Jeff-Birt/MOS8701_HB/Soldering Fixture/IMG_8996.JPG

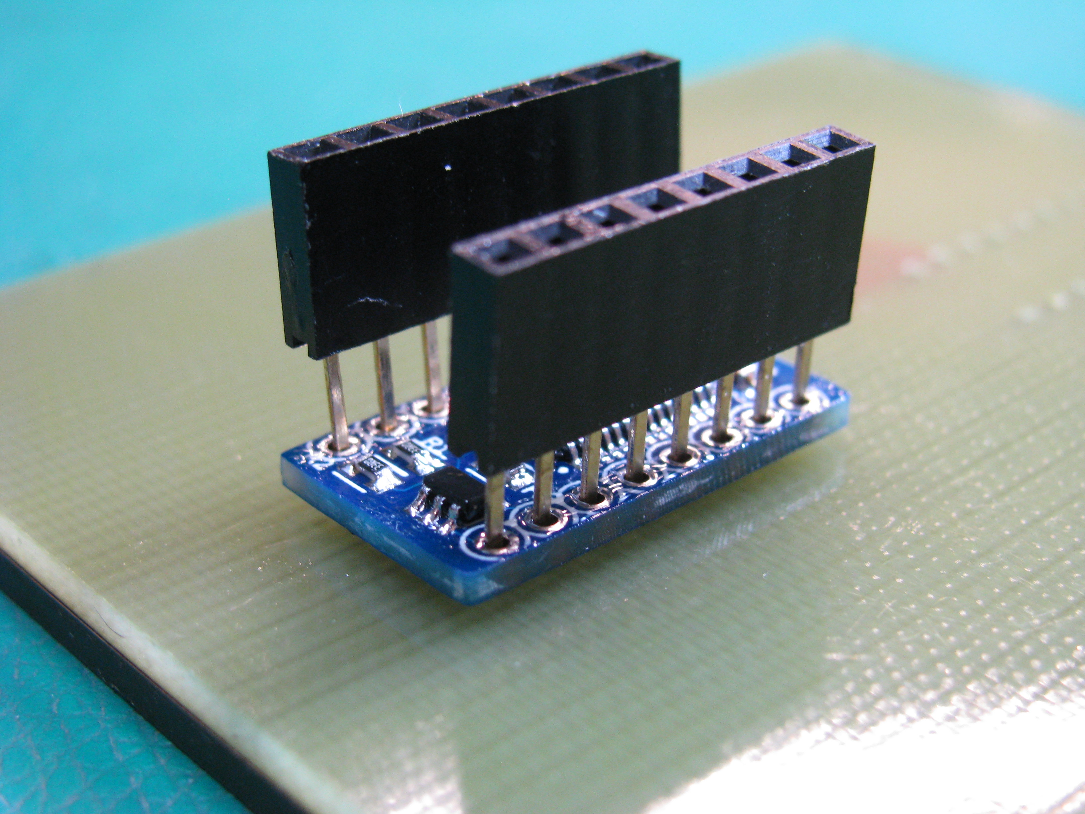
Soldering Fixture/IMG_8996.JPG
