Jeff-Birt/MOS8701_HB/Test Fixture/IMG_8955.JPG

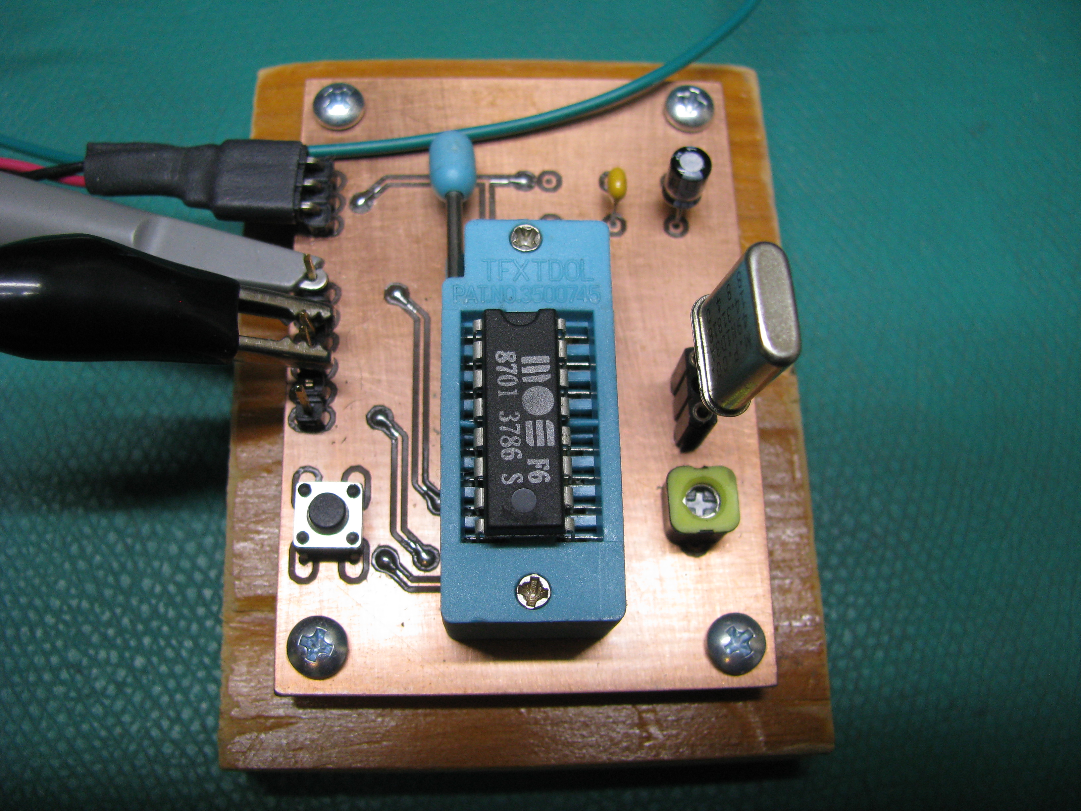
Test Fixture/IMG_8955.JPG
