Jeff-Birt/MOS8701_HB/README.md

# MOS8701_HB
Project files for a MOS8701 replacement. More documentation forthcoming.

For now see: https://youtu.be/e5o8c656j3Q
