Jeff-Birt/MOS8701_HB/Lead Forming Die/Lead Forming Die Set v10.png

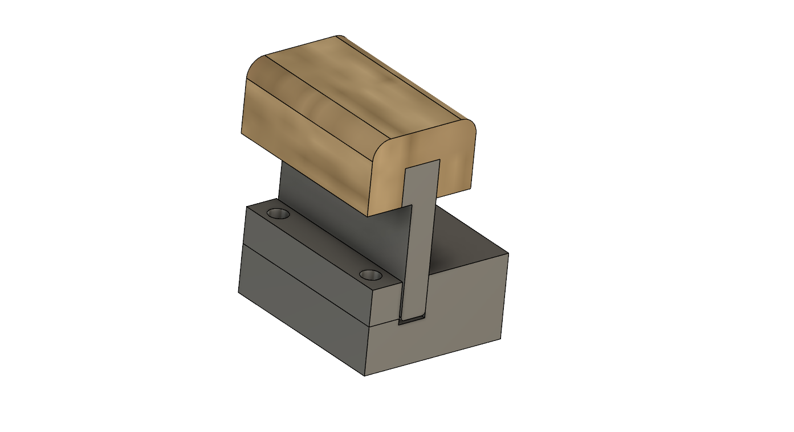
Lead Forming Die/Lead Forming Die Set v10.png
