Jeff-Birt/MOS8701_HB/Lead Forming Die/WP_20200714_13_27_40_Pro.jpg

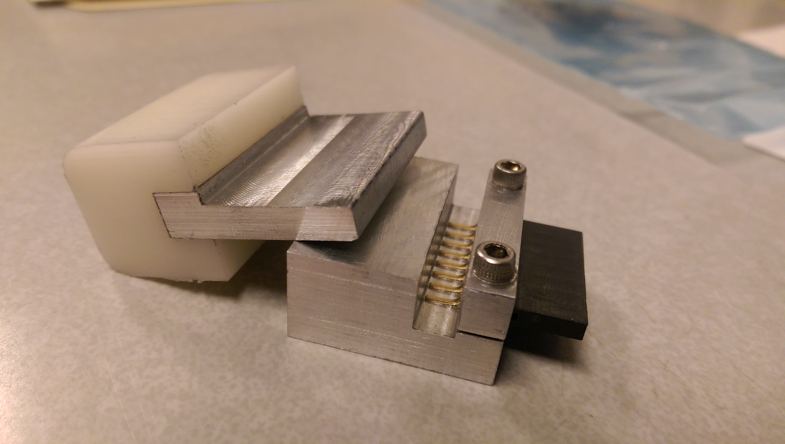
Lead Forming Die/WP_20200714_13_27_40_Pro.jpg
