Jeff-Birt/MOS8701_HB/MOS8701_HB/IMG_8985.JPG

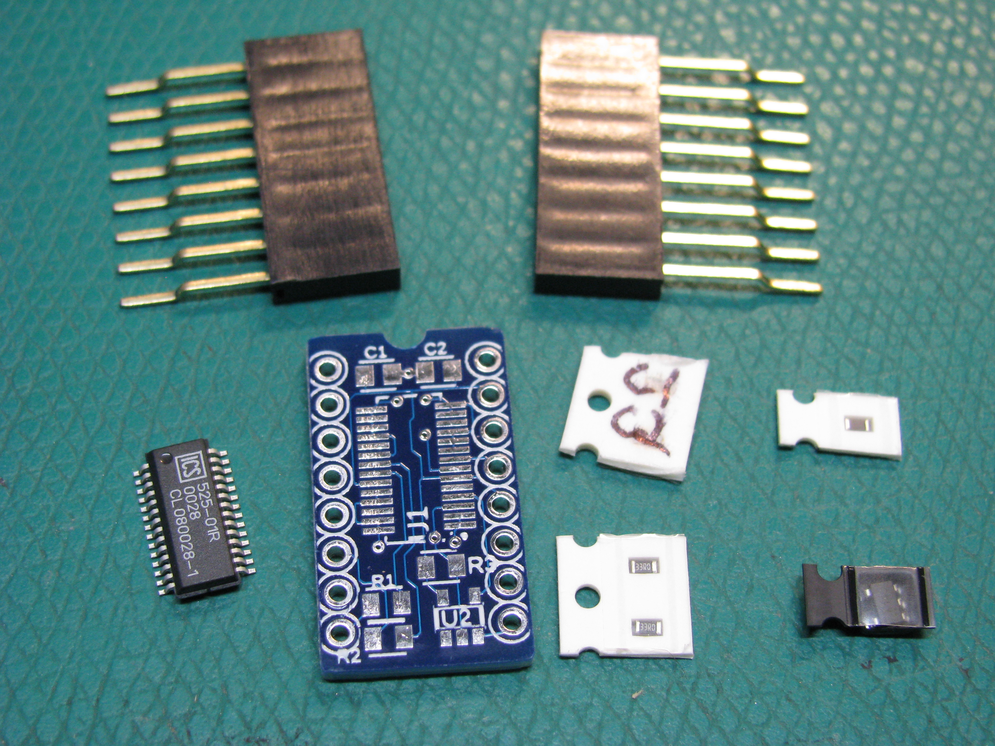
MOS8701_HB/IMG_8985.JPG
