Jeff-Birt/MOS8701_HB/MOS8701_HB/IMG_9003.JPG

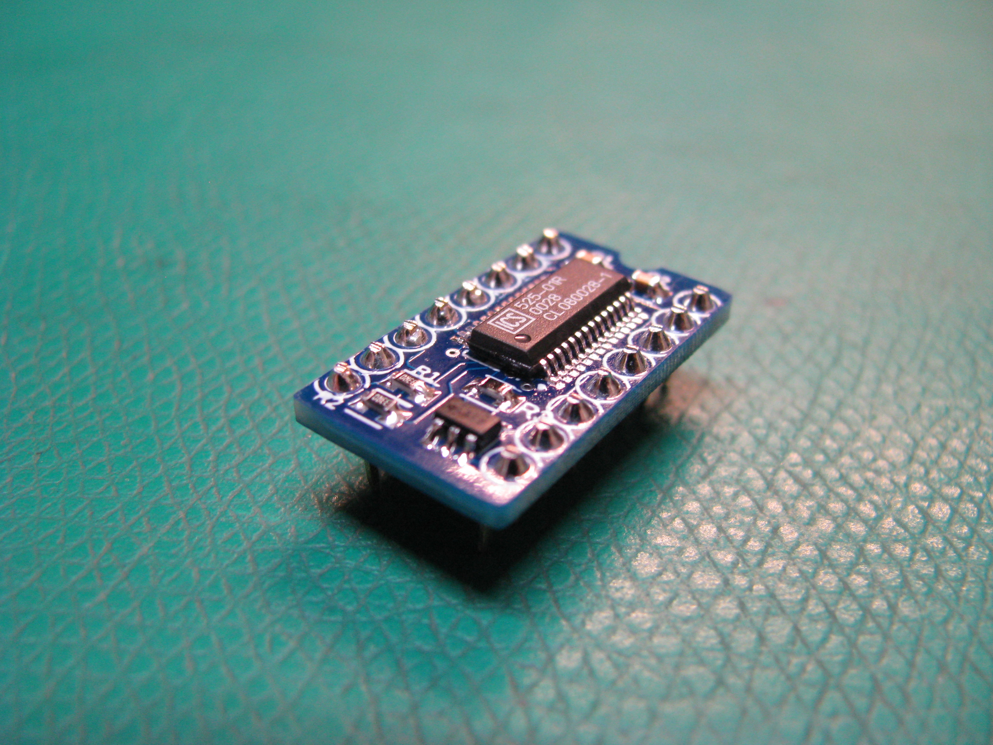
MOS8701_HB/IMG_9003.JPG
