Jeff-Birt/MOS8701_HB/MOS8701_HB/IMG_9005.JPG

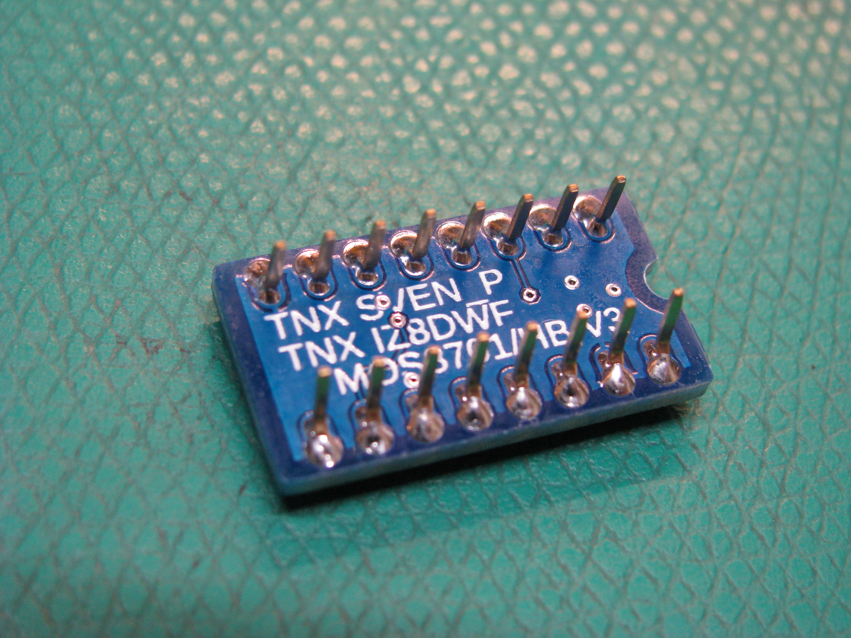
MOS8701_HB/IMG_9005.JPG
