Jeff-Birt/MOS8701_HB/MOS8701_HB/MOS8701_HB Rear v9.png

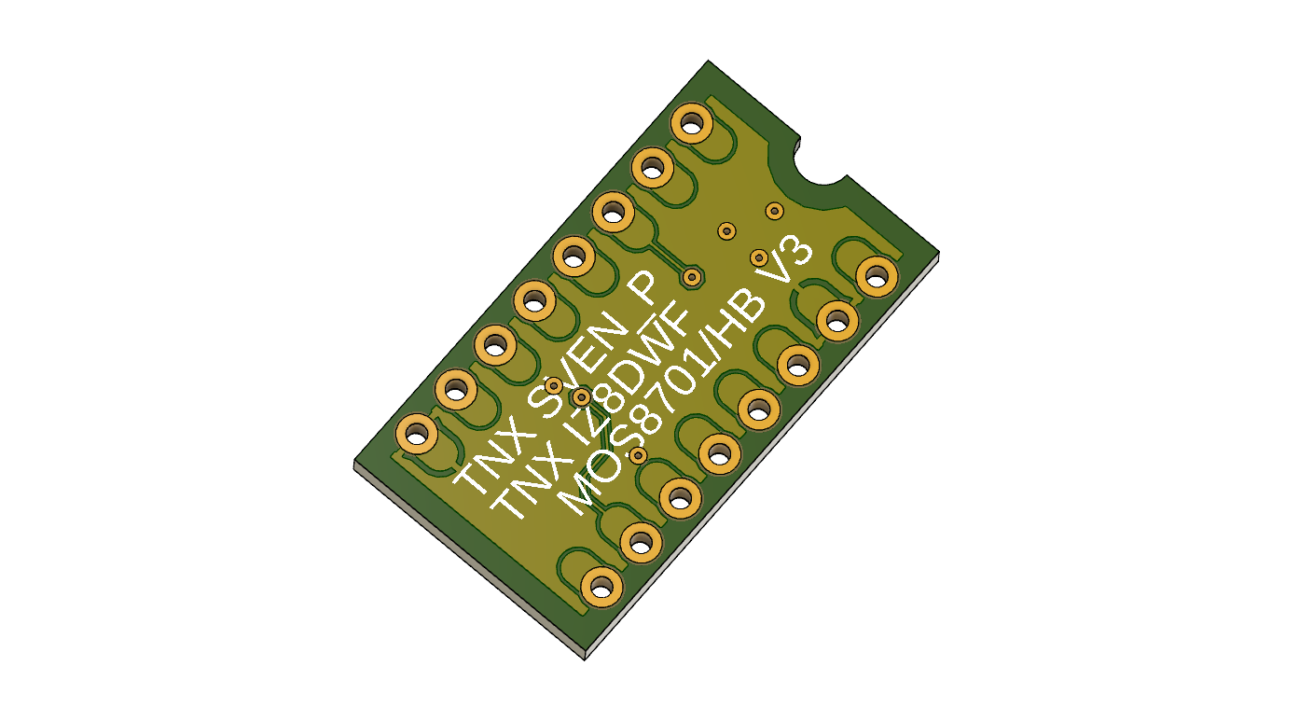
MOS8701_HB/MOS8701_HB Rear v9.png
