Jeff-Birt/MOS8701_HB/MOS8701_HB/MOS8701_HB v8 Component Placement.png

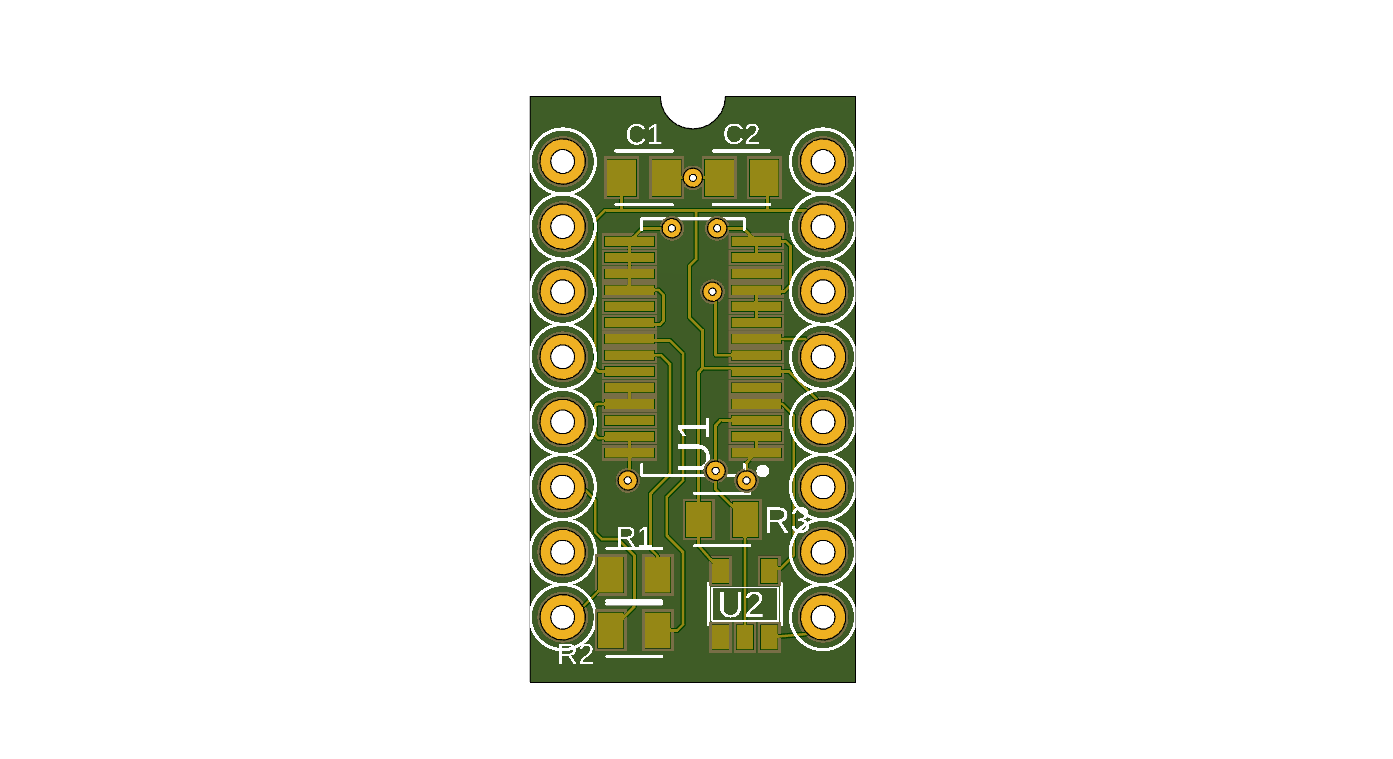
MOS8701_HB/MOS8701_HB v8 Component Placement.png
