Jeff-Birt/MOS8701_HB/Soldering Fixture/Toolpath/Soldering FIxture v1 Sheet1.dxf

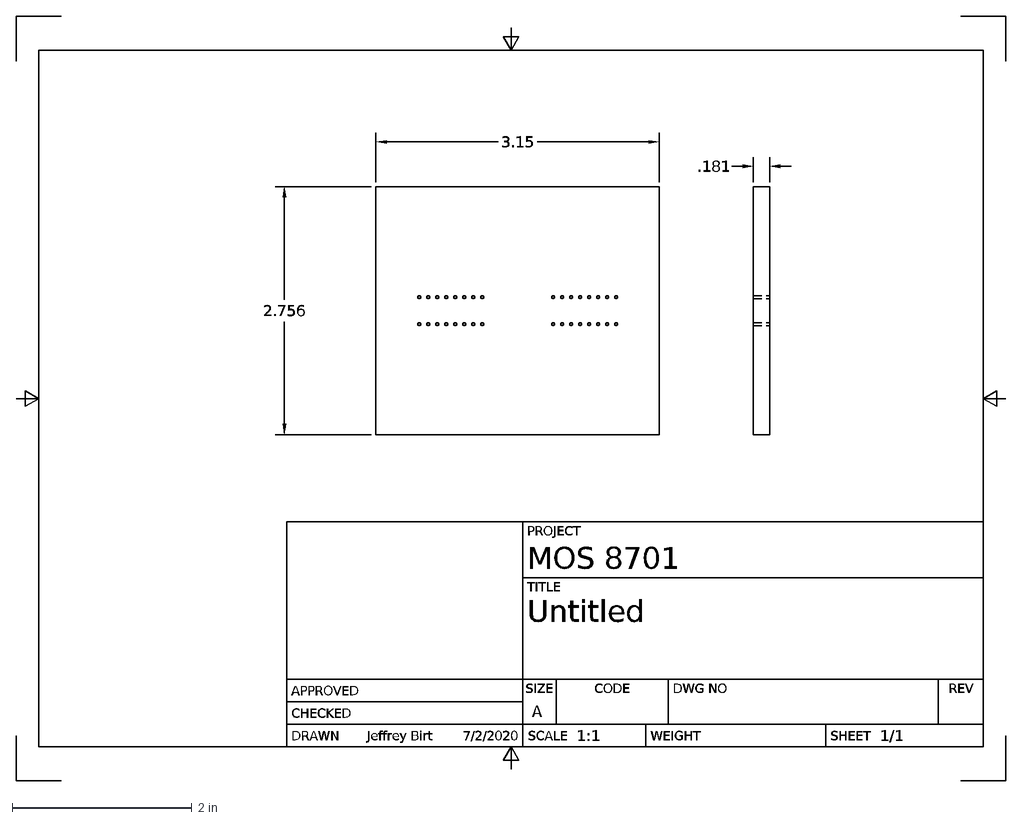
[picture p12: CAD file, 2020-08-23]
Soldering Fixture/Toolpath/Soldering FIxture v1 Sheet1.dxf
1/1
1:1
7/2/2020
Jeffrey Birt
A
MOS 8701
Untitled
PROJECT
TITLE
DRAWN
CHECKED
APPROVED
SCALE
WEIGHT
SHEET
DWG NO
REV
CODE
SIZE
3.15
2.756
.181
