Jeff-Birt/MOS8701_HB/Lead Forming Die/Old 3D Printed Version/Lead Forming Die v6.stl

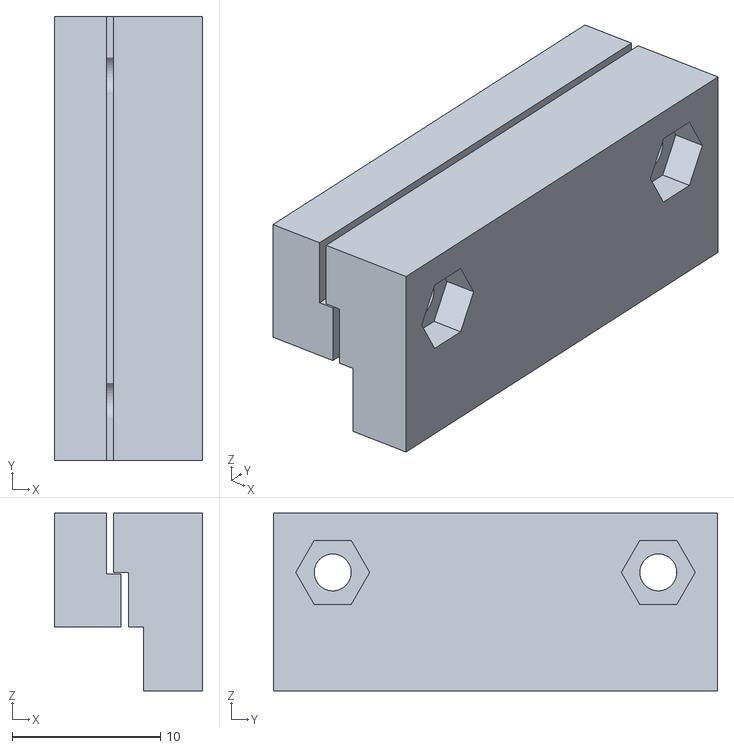
[picture p13: CAD file, 2020-08-23, an earlier design]
Lead Forming Die/Old 3D Printed Version/Lead Forming Die v6.stl
10.0 x 30.0 x 12.0
