Jeff-Birt/MOS8701_HB/(list of files, cad)

Other CAD files:
Lead Forming Die/Lead Forming Die Set v11.f3d
Soldering Fixture/Soldering Fixture v1.f3d
