Jeff-Birt/MOS8701_HB/MOS8701_HB/MOS8701_HB Schematic V8.pdf

2 | 4 U2 R³ | 3 5 GND VCC U2P

A

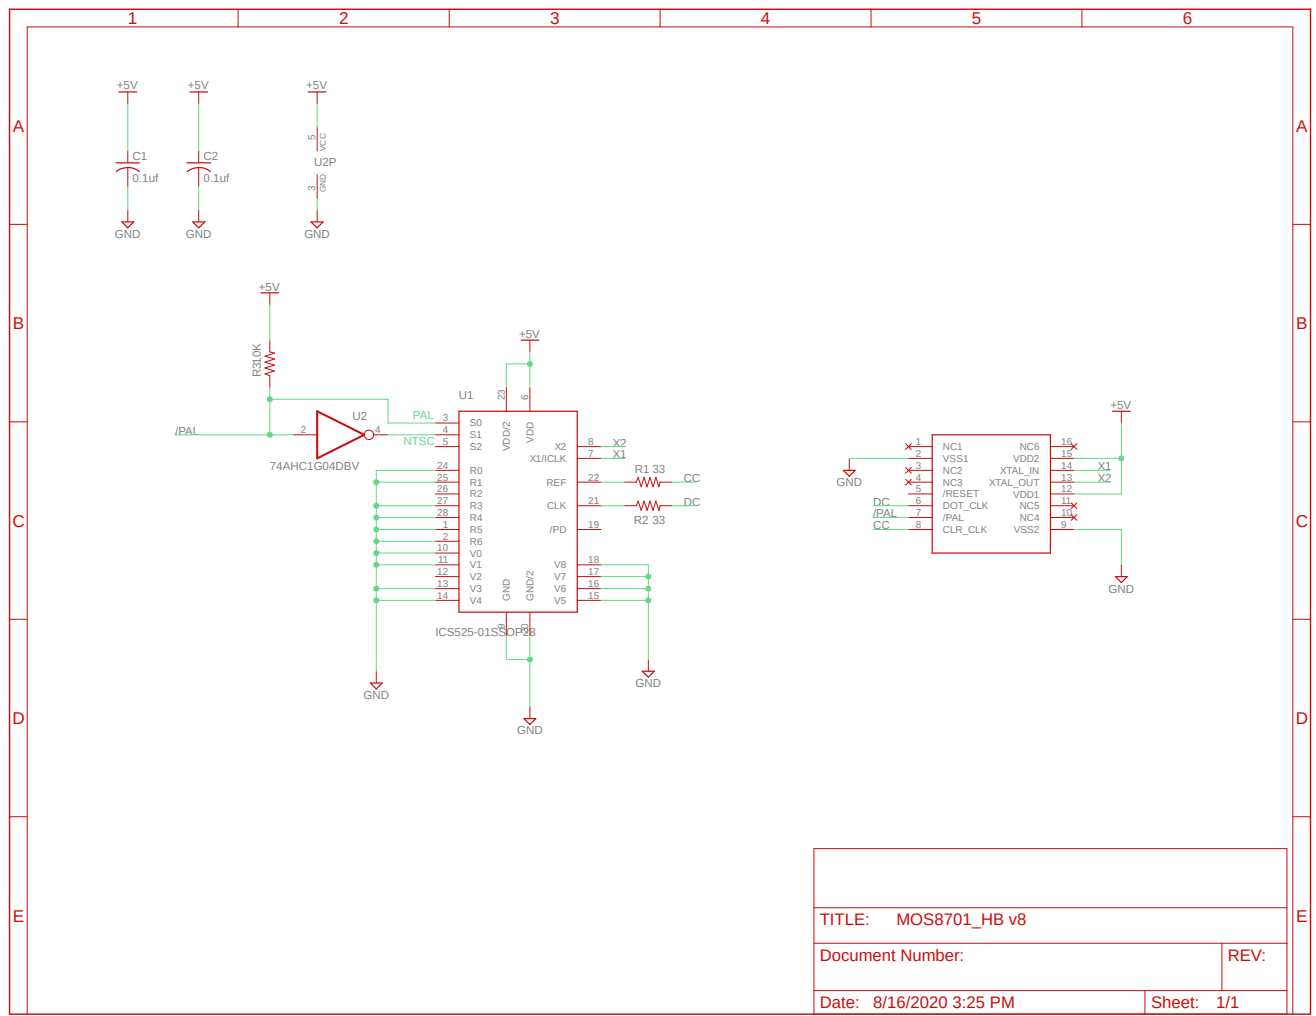
[picture p14: page 1]

9 V0 10 V1 11 V2 12 V3 13 V4 14 R4 28 R3 27 R2 26 R1 25 R0 24 VDD/2 23 GND/2 20 REF 22 CLK 21
PAL

Document Number: | REV:

Date: 8/16/2020 3:25 PM | Sheet: 1/1
