Jeff-Birt/MOS8701_HB/Soldering Fixture/Soldering FIxture v2.pdf

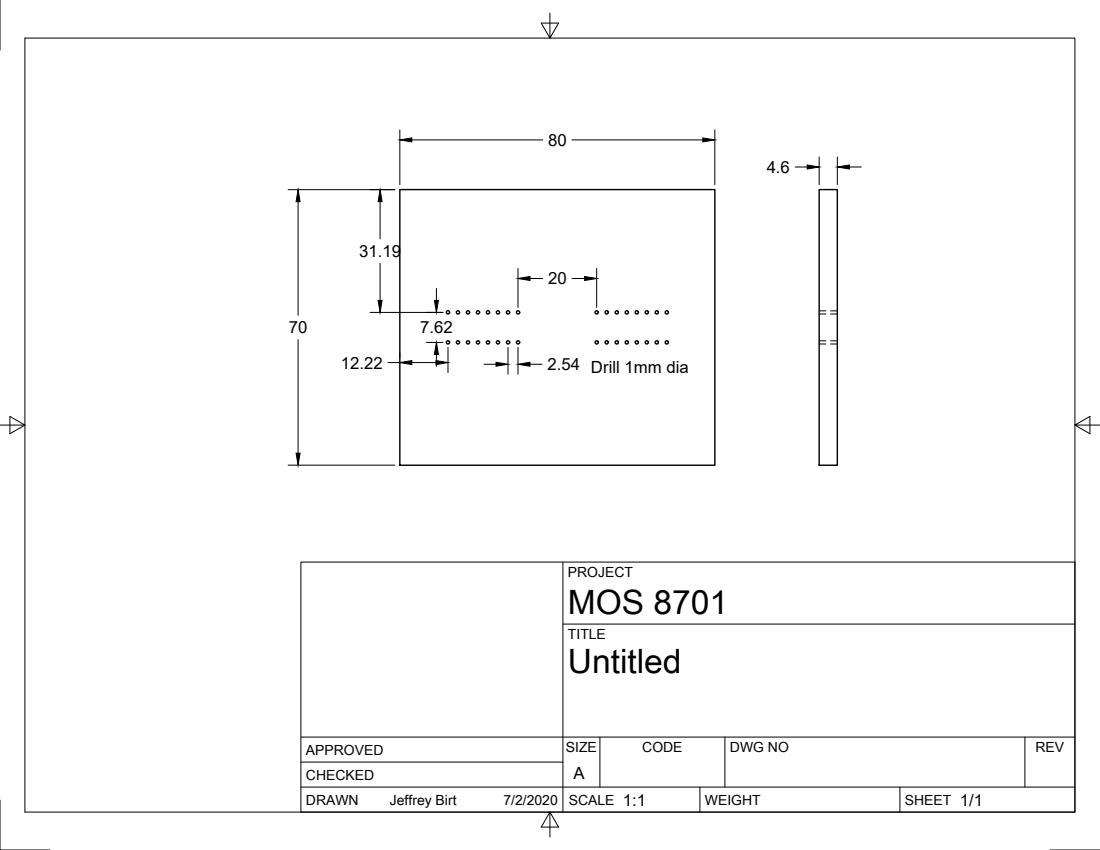
[picture p15: page 1]
SIZE; CODE; DWG NO; REV; Jeffrey Birt; MOS 8701; Drill 1mm dia
