Jeff-Birt/MOS8701_HB/Test Fixture/MOS8701_HB Test Fixture Schematic.pdf

# GND ⁺⁵V

A

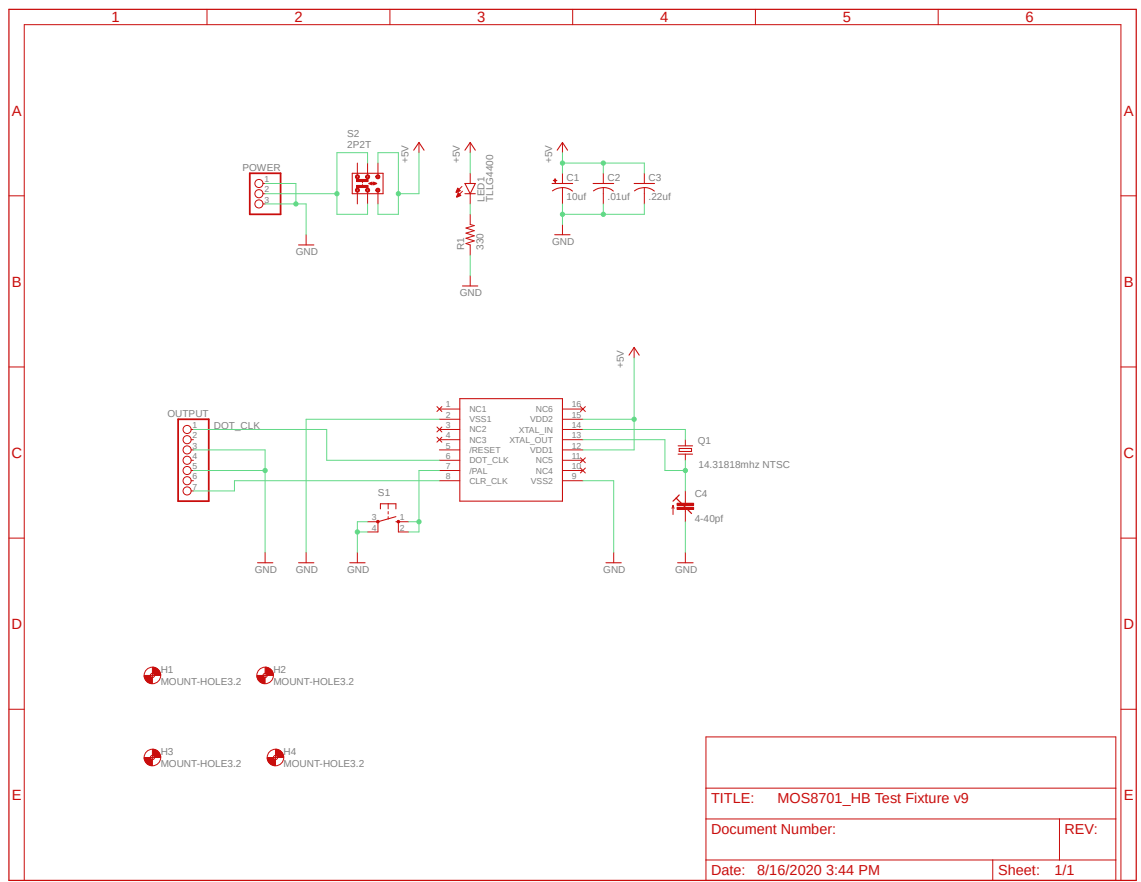
[picture p16: page 1]
14.31818mhz NTSC; GND; GND GND; MOUNT-HOLE3.2; TLLG⁴⁴⁰⁰ 330 +5V; VSS1 2; /RESET 5; DOT_CLK 6; CLR_CLK 8; /PAL 7; 11 VDD2; 15 VDD1; 12 XTAL_IN; 14 XTAL_OUT; 13 VSS2; 7 OUTPUT; 3 POWER; LED¹ R¹; DOT_CLK; TITLE:; MOS8701_HB Test Fixture v9

Document Number: | REV:

Date: 8/16/2020 3:44 PM | Sheet: 1/1
