Jeff-Birt/MOS8701_HB/Lead Forming Die/Lead Forming Die Block v1.pdf

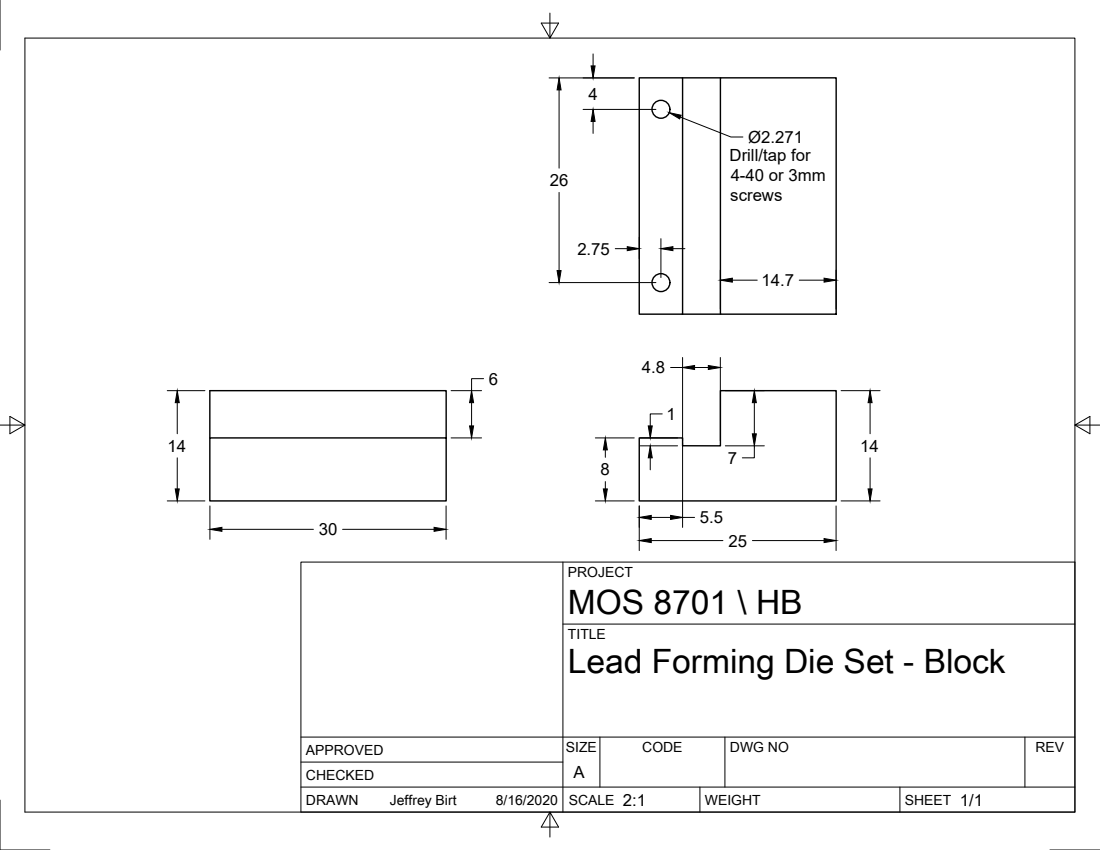
[picture p17: page 1]
SIZE; CODE; DWG NO; REV; Jeffrey Birt; Drill/tap for 4-40 or 3mm

PROJECT
MOS 8701 \ HB
Lead Forming Die Set - Block
