Jeff-Birt/MOS8701_HB/Lead Forming Die/Lead Forming Die Clamp v3.pdf

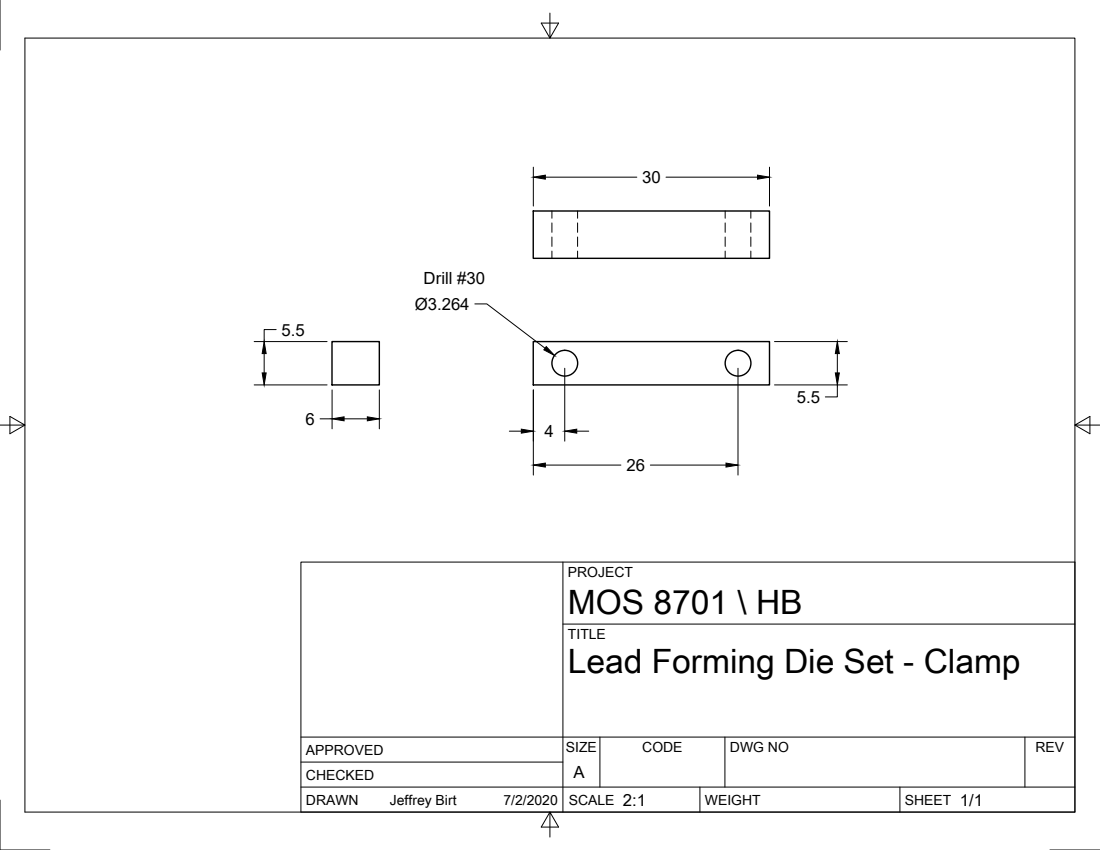
[picture p18: page 1]
SIZE; CODE; DWG NO; REV; Jeffrey Birt; Drill #30

PROJECT
MOS 8701 \ HB
Lead Forming Die Set - Clamp
