Jeff-Birt/MOS8701_HB/Lead Forming Die/Lead Forming Die Punch v5.pdf

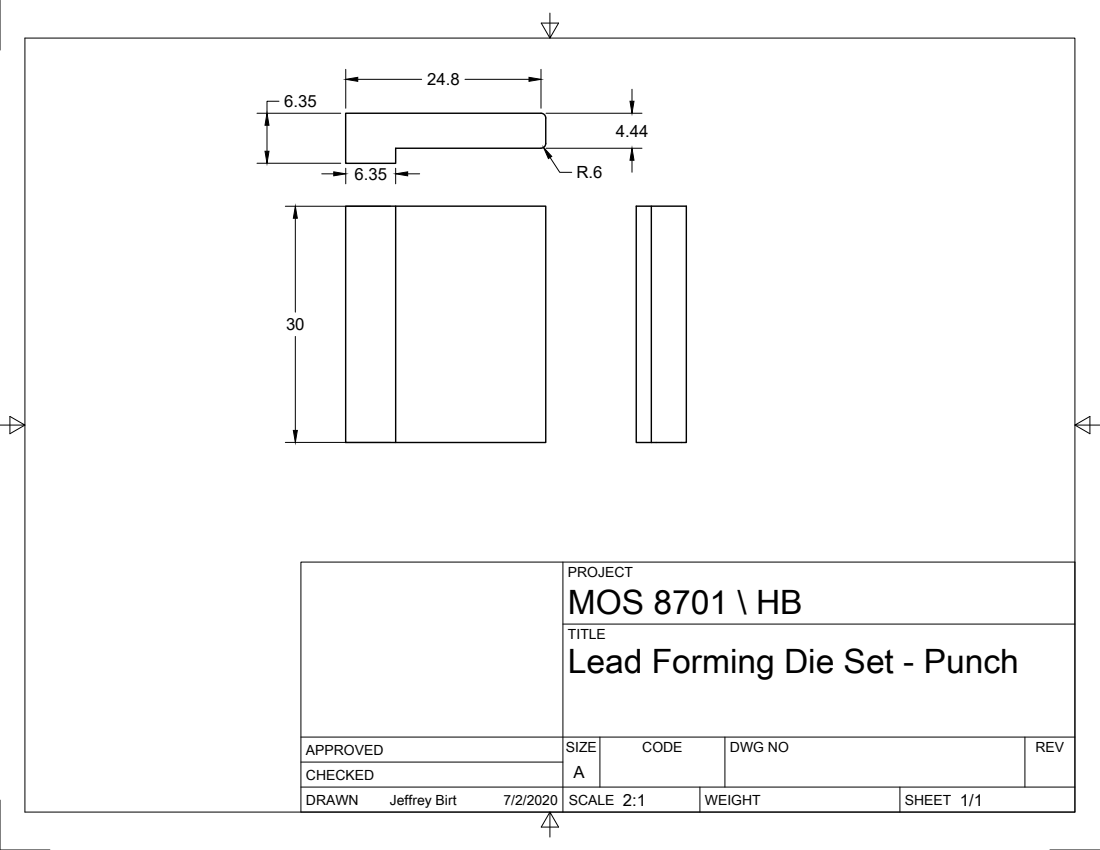
[picture p19: page 1]
SIZE; CODE; DWG NO; REV; Jeffrey Birt

PROJECT
MOS 8701 \ HB
Lead Forming Die Set - Punch
