Jeff-Birt/MOS8701_HB/Soldering Fixture/IMG_8986.JPG

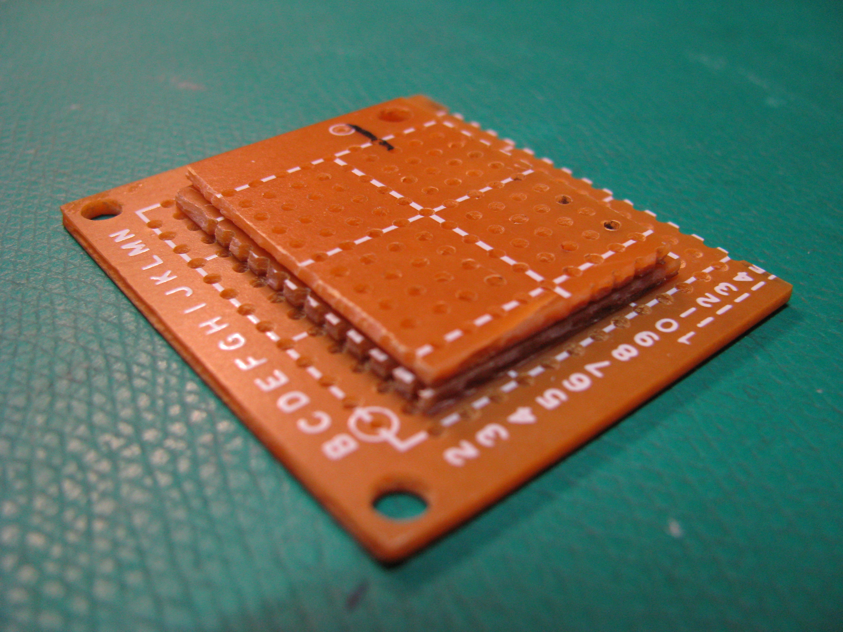
Soldering Fixture/IMG_8986.JPG
