Jeff-Birt/MOS8701_HB/(commit log)

2020-08-23 Initial commit of project files
    [Lead Forming Die Set v11.f3d, Lead Forming Die v6.stl, Soldering FIxture v1 Sheet1.dxf, Soldering Fixture v1.f3d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]
2020-08-31 Added PDF of assembly manual
